dd060606/RedUSB/PCB/production/bom.csv

Designator | Footprint | Quantity | Value | LCSC Part #
C1 | 0603 | 1 | 100nF
D1 | LED_RGB_Wuerth-PLCC4_3.2x2.8mm_150141M173100 | 1 | WL-SFTW_3528_PLCC4
F1 | 0805 | 1 | 500mA
J1 | 629004113921 | 1 | 629004113921
R1, R2 | 0603 | 2 | 27R
R3 | 0603 | 1 | 220R
R4, R5 | 0603 | 2 | 150R
S1 | SW_EVQ-P7A01P | 1 | EVQ-P7A01P
S2 | SW_JS102011SAQN | 1 | JS102011SAQN
U1 | kb2040 | 1 | kb2040
U2 | SOT-23-6_Handsoldering | 1 | USBLC6-2SC6
