dd060606/RedUSB/3D/Lid.3mf

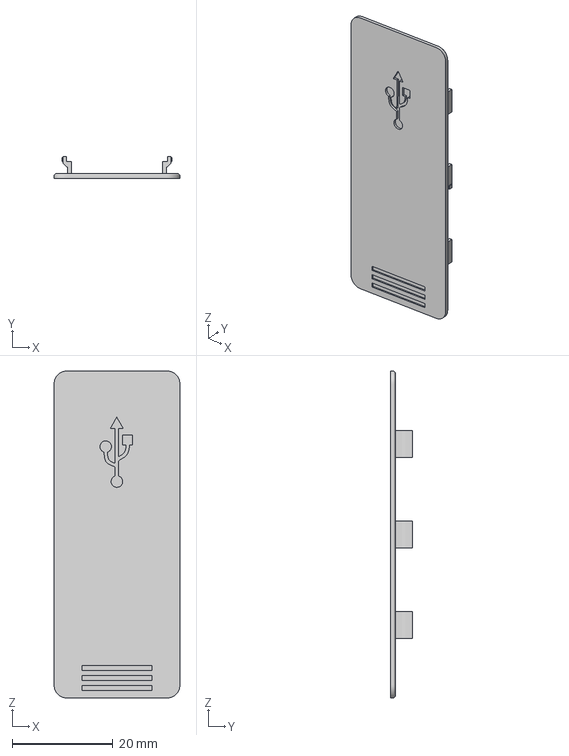
[picture p1: CAD file, 2026-09-11]
3D/Lid.3mf
25.0 x 4.40 x 65.0 mm
