dd060606/RedUSB/PCB/RedUSB.step

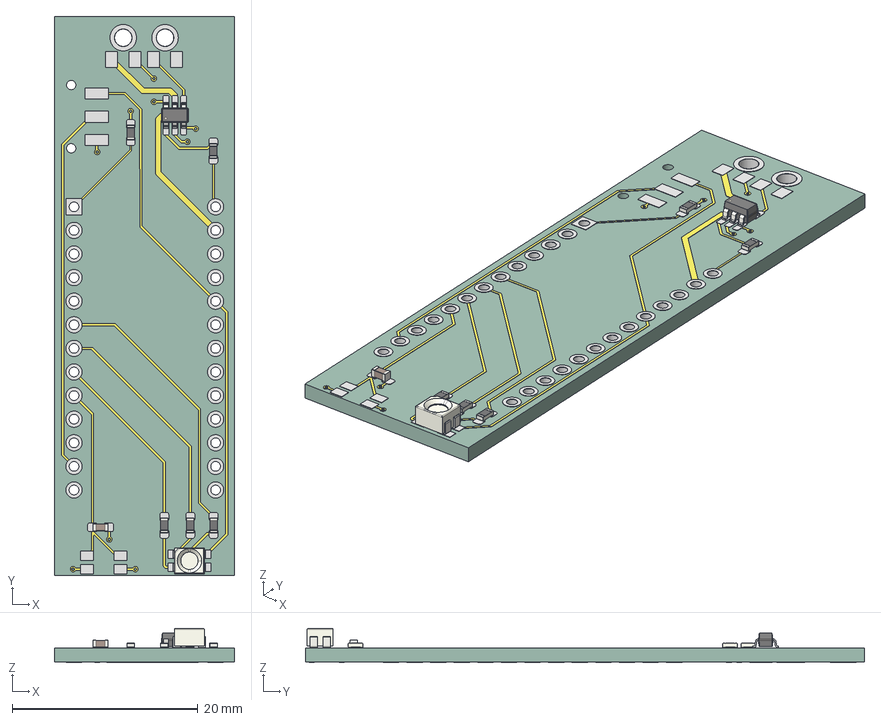
[picture p2: CAD file, 2026-09-11]
PCB/RedUSB.step
19.4 x 60.2 x 3.68 mm
LED_RGB_Wuerth-PLCC4_3.2x2.8mm_150141M173100
SOT-23-6
R_0603_1608Metric x 5
C_0603_1608Metric
RedUSB_copper
RedUSB_pad
RedUSB_via
RedUSB_PCB
