dd060606/RedUSB/3D/Case.3mf

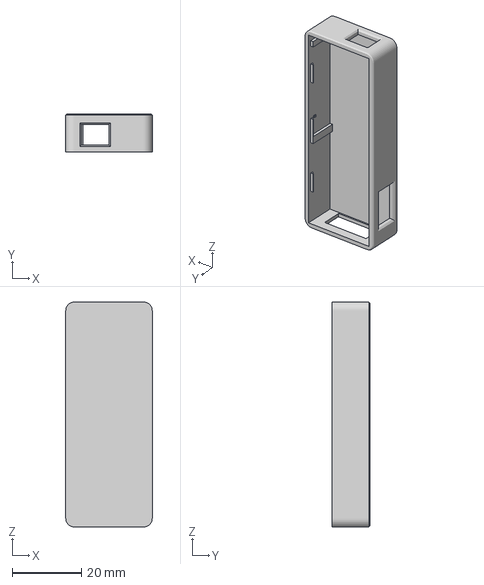
[picture p3: CAD file, 2026-09-11]
3D/Case.3mf
25.0 x 11.0 x 65.0 mm
