dd060606/RedUSB/(list of files, cad)

Other CAD files:
3D/RedUSB_Case.gcode.3mf
