dd060606/RedUSB/PCB/RedUSB.kicad_pcb

## KiCad design PCB/RedUSB.kicad_pcb (2026-11-05)

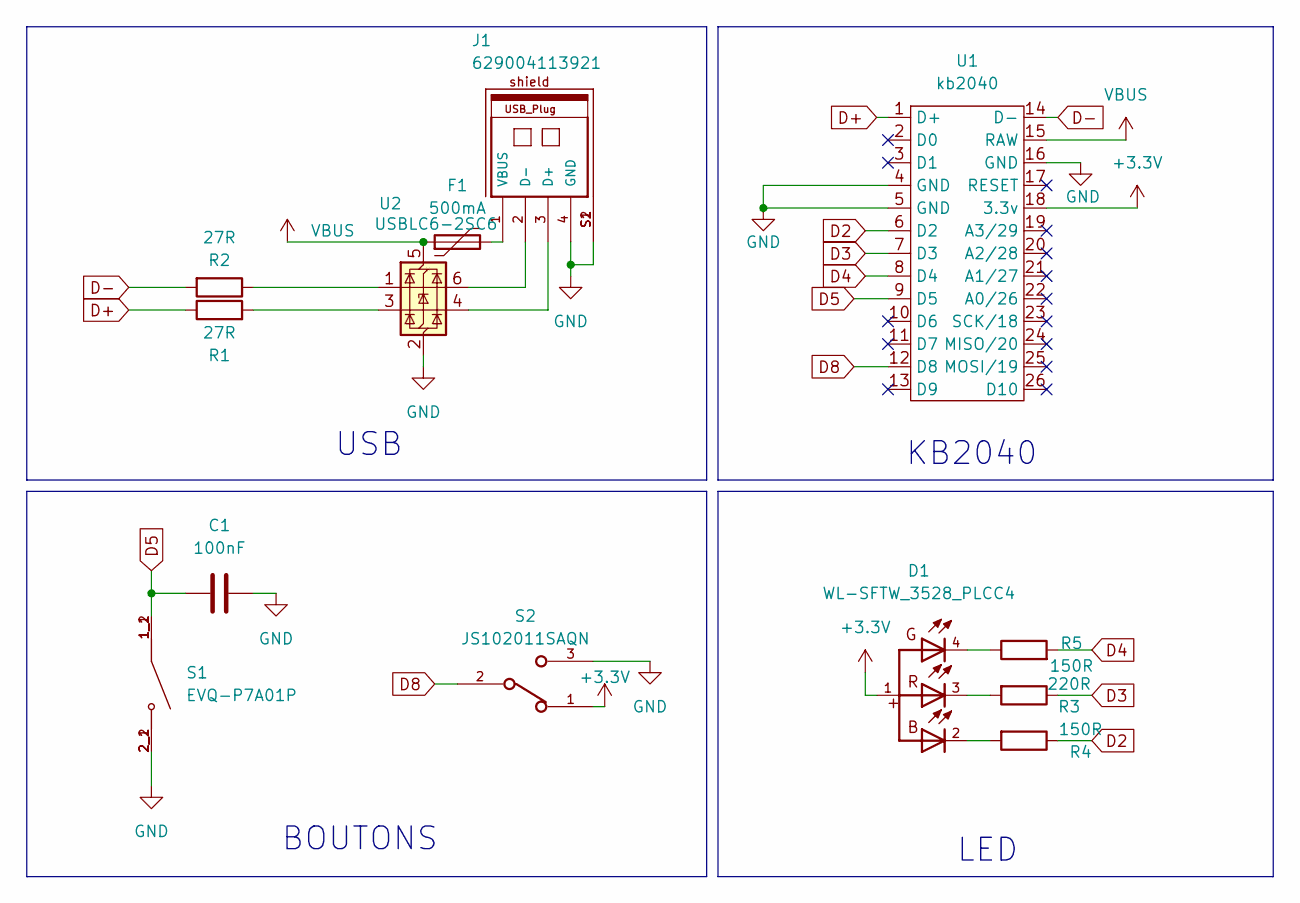
[picture p4: schematic RedUSB.kicad_sch]

Parts:
C1: 100nF; C_0603_1608Metric_Pad1.08x0.95mm_HandSolder
D1: WL-SFTW_3528_PLCC4; LED_RGB_Wuerth-PLCC4_3.2x2.8mm_150141M173100
F1: 500mA; Fuse_0805_2012Metric_Pad1.15x1.40mm_HandSolder
J1: 629004113921
R1, R2: 27R; R_0603_1608Metric_Pad0.98x0.95mm_HandSolder
R3: 220R; R_0603_1608Metric_Pad0.98x0.95mm_HandSolder
R4, R5: 150R; R_0603_1608Metric_Pad0.98x0.95mm_HandSolder
S1: EVQ-P7A01P; SW_EVQ-P7A01P; PARTREV 2022.4
S2: JS102011SAQN; SW_JS102011SAQN
U1: kb2040
U2: USBLC6-2SC6; SOT-23-6_Handsoldering

Connections:
+3.3V: D1.1, S2.1, U1.18 (3.3v)
D2: R4.1, U1.6 (D2)
D3: R3.1, U1.7 (D3)
D4: R5.2, U1.8 (D4)
D5: C1.1, S1.1_1, S1.1_2, U1.9 (D5)
D8: S2.2, U1.12 (D8)
D+: R1.1, U1.1 (D+)
D-: R2.2, U1.14 (D-)
GND: C1.2, J1.4 (GND), J1.S1, J1.S2, S1.2_1, S1.2_2, S2.3, U1.4 (GND), U1.5 (GND), U1.16 (GND), U2.2 (GND)
unnamed: D1.2, R4.2
unnamed: D1.3, R3.2
unnamed: D1.4, R5.1
unnamed: J1.3 (D+), U2.4 (I/O2)
unnamed: J1.2 (D-), U2.6 (I/O1)
unnamed: F1.2, J1.1 (VBUS)
unnamed: R1.2, U2.3 (I/O2)
unnamed: R2.1, U2.1 (I/O1)
VBUS: F1.1, U1.15 (RAW), U2.5 (VBUS)

Notes on the sheet:
KB2040
BOUTONS
USB
LED

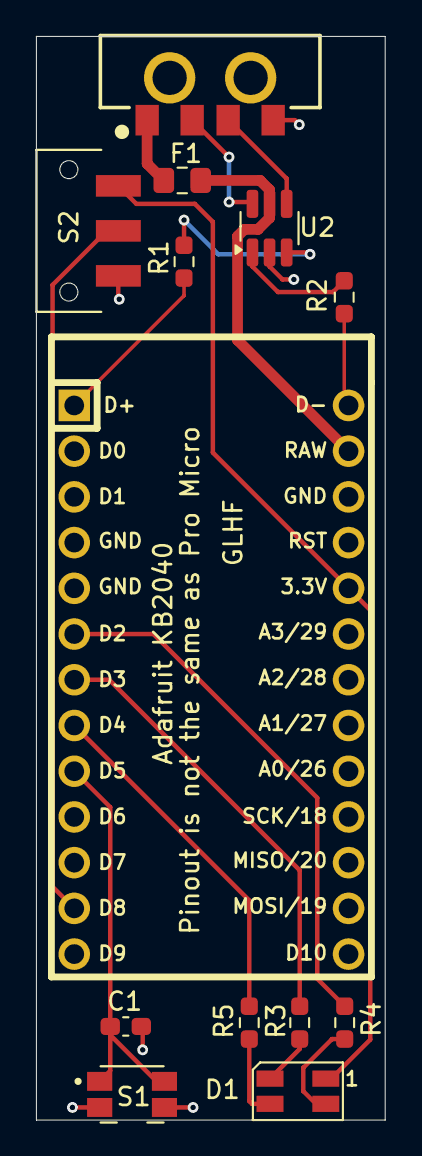
[picture p5: board RedUSB.kicad_pcb from above]

Board: 2 copper layers, 19.4 x 60.2 mm, 13 parts (0 on the bottom side), 18 nets.
