dd060606/RedUSB/(commit log)

2026-09-06 electrical schematic
    [RedUSB.kicad_pcb, RedUSB.kicad_sch]
2026-09-07 feat: PCB
    [RedUSB.kicad_pcb]
2026-09-08 feat: production files for PCB assembly
    [RedUSB.step, bom.csv, designators.csv, positions.csv]
2026-09-11 feat(PCB): add 500mA fuse
    [Case.3mf, Lid.3mf, RedUSB.kicad_pcb, RedUSB.kicad_sch, RedUSB.step, RedUSB_Case.gcode.3mf, bom.csv, designators.csv]
2026-09-16 feat(firmware): add device firmware
2026-11-05 feat(pcb): update PCB design files
    [RedUSB.kicad_pcb, designators.csv]
2026-11-05 feat(firmware): enhance error handling and LED brightness control
    [led.rs]
2026-11-05 feat(firmware): add OS fingerprinting and improve device enumeration
